4lc0n/MoCoBiBa/writedown.odt

Writedown MoCoBiBa

# Schaltplan

# Verbesserungsvorschläge:

# C direkt an Buck-Converter Vin

# Reverse Polarity Protection am Eingang (Schottky-Diode oder PMOS)

# V+ des Programmieradapter nicht routen, Buck Converter mag das nicht!

# Software

## Analog Input

Discarding first 10 inputs isn’t sufficient, changed to discard at least 30 samples

## LOW POWER

Thoughts:

- Sleep Mode with Watchdog Interrupt or MPU-Interrupt
- for normal operations: consider using 128kHz Watchdog Clock source
  - uses ~ 10 time less power
  - takes 10 times more to perform operations
- Checking for Light condition may be more current consuming than letting mpu run, because bike will be standing in the dark most of the day → Motion is a better Indicator for Riding
  - When Motion detected: Start sampling in low power mode

## Detecting Motion

- Sample MPU pretty slowly (32Hz should be sufficient for motion detection)
- either accel in z-direction (x, y may varry because if bike lays on one side)
  - acc-threshhold for pedaling, braking
- or calculate g-force, if g > 1.2 → Motion

# Löten

## Lötpaste auftragen

- Mit anderen Platinen einen ‘Cage’ aufbauen, in welchen die zu lötende Platine eingeklemmt wird.
- Mit Isolierband befestigt
- etwas Lötpaste am oberen Rand der Schablone auftragen
- mit z.B. einer Plastikkarte über die Schablone ziehen, auf guten Anpressdruck der Schablone achten, sonst verläuft die Paste
- bei kleinen Footprints (QFN o.Ä.) wenn Möglich etwas weniger auftragen, sonst Lötbrücken!

## Heißluft-Löten

- Umliegende Fläche aufheizen lassen
- ~~330°C,~~ Luftstrom Stufe 5, Temperatur: 270°C, verhindert dass Buck-Converter kaputt geht!
- kleinere Mittlere Düse für kleine Bauteile wie 0805 SMD
- bei Ics mit SOIC Füße einzeln erhitzen, diese sind groß genug, dass es sie fast nicht verzieht

Problem mit MPU-6500:

einige Lötbrücken entstanden

- wieder herauslöten mit Heißluft und Flussmittel
- mit Kupferlitze Lötzinn entfernen
- mit Zahnstocher geringste Mengen auftragen. Es ist wenig nötig, da bereits das Pad und die Füße bezinnt sind
- IC wieder auf Footprint setzen
- verlöten und beten, dass keine Lötbrücken entstehen!

Beim ersten Versuch ist eine Lötbrücke zw. VDDIO und AUX_CK, diese Stört aber (hoffentlich) nicht, da AUX_CK nicht verwendet wird (störte scheinbar doch)

Kurzschluss zwischen 3V3 und GND

- MPU-6500 verursachte Kurzschluss
- herunterlöten, Lötpads säubern, neu rauflöten hat das Problem gelöst

Lötpaste unter ATTINY84

- muss noch mal gereflowed werden!

Stromversorgung:

mit Kurzschluss/Lötbrücke am MPU-6500 hat der Spannungsregler keine Ausgangsspannung geliefert → Kurzschlussschutz?

Kurzschluss zw. SW und GND bzw 32Ω Widerstand

bei zweitem Buck-Converter: Kurzschluss zw. Vin und GND

–> Lösung: Temperatur von 330°C auf 270°C reduzieren, da IC nur max. 250°C aushält

ggf. Mit Lötkolben Pins nachlöten, wenn diese nicht heiß genug durch Luftstrom werden

# Programmieren

## Pin-Configuration

Alle Pins als Input, PULLUP

PIN | Direction | Value
DEBUG0 | 0 | 0
DEBUG1 | 0 | 0
LED | 0 | 0
ACC_INT | 0 | 0
V_BATT | 0 | 0
V_LIGHT | 0 | 0
V_SINK | INPUT | No pullup

## MPU-6500

Library für Attiny: usiTwiMaster von Donald R. Blake

Funktioniert auch mit 1MHz internal Clock

## ADC

Vorerst für 1MHz Clock konfiguriert

- ADC aktivieren
- Division Faktor auf 16 setzen → 62,5 kHz Clock (muss zw. 50K und 200kHz sein)
- ADCMUX [7:6] auf 0 → VCC als REF; [5:0] auf 1 → ADC1
- disable digital input buffer: DIDR0 auf a (PA1 und PA3 disable)
