4lc0n/MoCoBiBa/3d/v01.FCStd

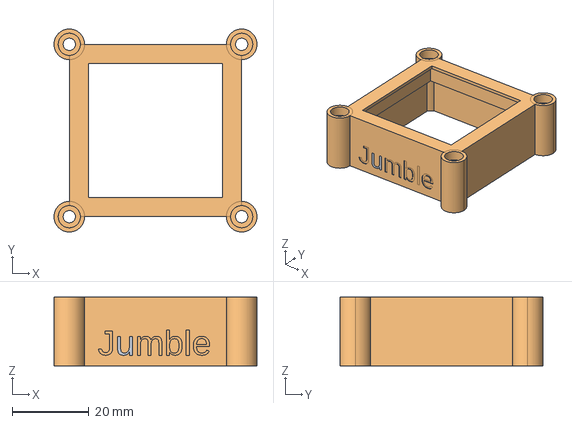
[picture p1: CAD file, 2020-11-13]
3d/v01.FCStd
53.0 x 53.0 x 18.0 mm
