4lc0n/MoCoBiBa/3d/v02_back_template.FCStd

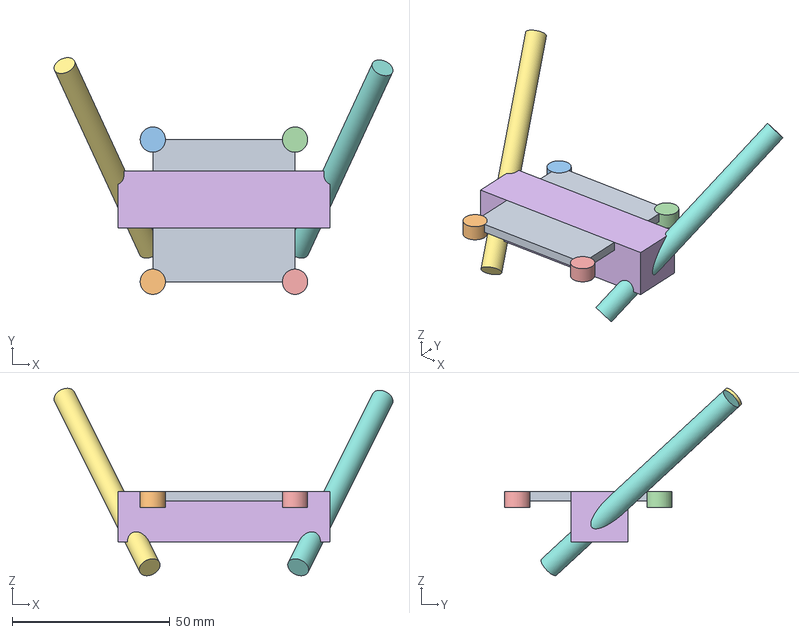
[picture p3: CAD file, 2020-11-13]
3d/v02_back_template.FCStd
107.3 x 74.9 x 59.4 mm
