4lc0n/MoCoBiBa/3d/v01_back_fem.FCStd

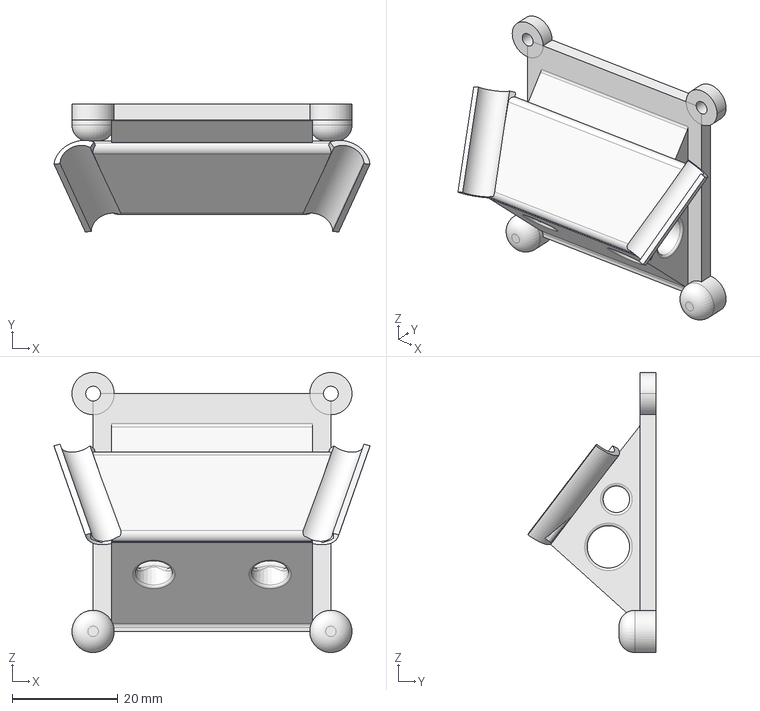
[picture p4: CAD file, 2020-11-13]
3d/v01_back_fem.FCStd
59.8 x 24.2 x 53.0 mm
