4lc0n/MoCoBiBa/3d/v01_rework_pre_zi.FCStd

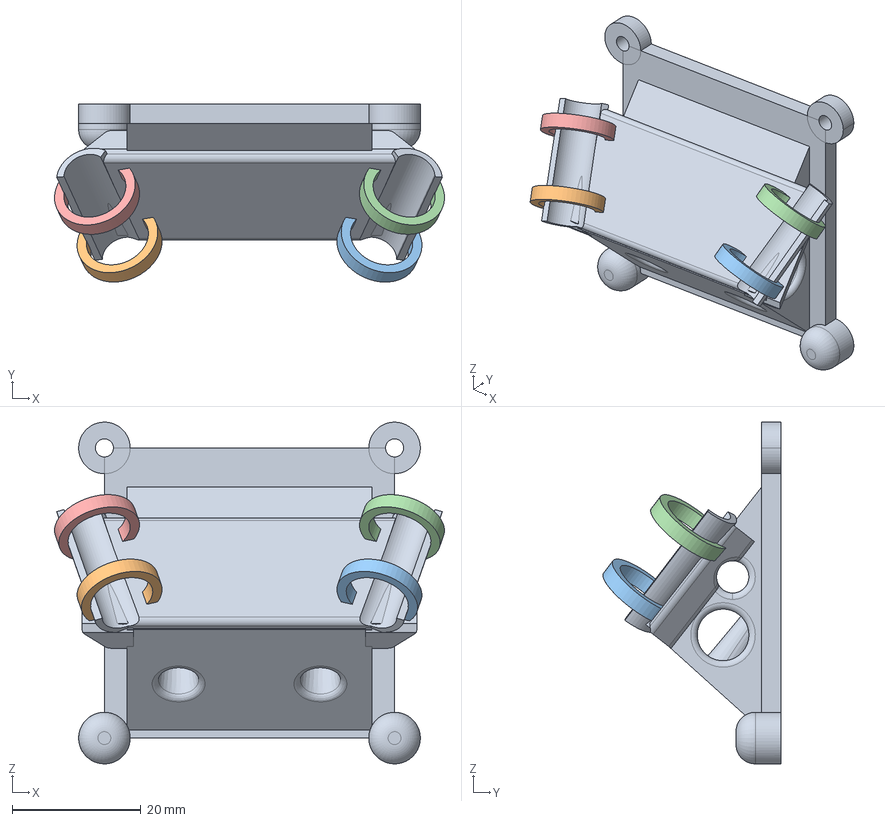
[picture p5: CAD file, 2020-11-13]
3d/v01_rework_pre_zi.FCStd
60.5 x 27.6 x 53.0 mm
lo
ru
ro
lu
