4lc0n/MoCoBiBa/3d/v02_2_back.FCStd

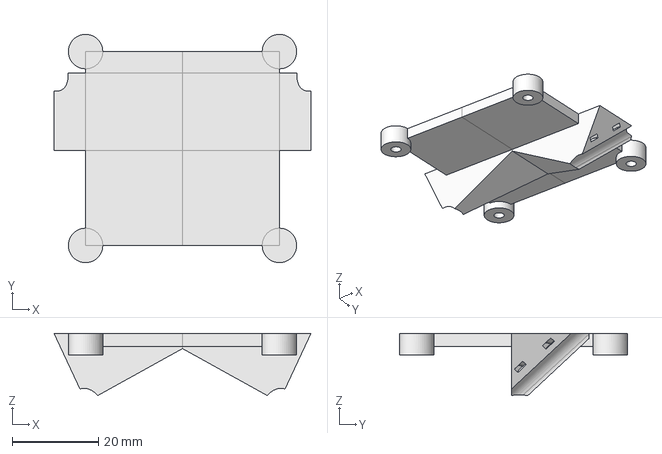
[picture p6: CAD file, 2020-11-13]
3d/v02_2_back.FCStd
59.7 x 53.0 x 14.5 mm
