4lc0n/MoCoBiBa/3d/v02_back.FCStd

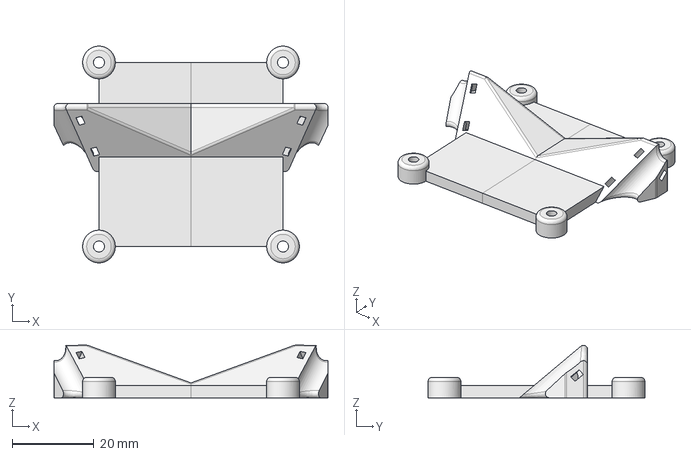
[picture p7: CAD file, 2020-11-13, an earlier design]
3d/v02_back.FCStd
67.0 x 53.0 x 12.8 mm
