4lc0n/MoCoBiBa/(list of files, cad)

Other CAD files:
3d/v01_rework.FCStd
3d/v01_back.FCStd
3d/v01.stl
3d/v01_back.stl
3d/v02_1_back.stl
3d/v02_2_back.stl
3d/v02_back.stl
