4lc0n/MoCoBiBa/MoCoBiBa/MoCoBiBa.kicad_pcb

## KiCad design MoCoBiBa/MoCoBiBa.kicad_pcb (2020-11-13, an earlier design)

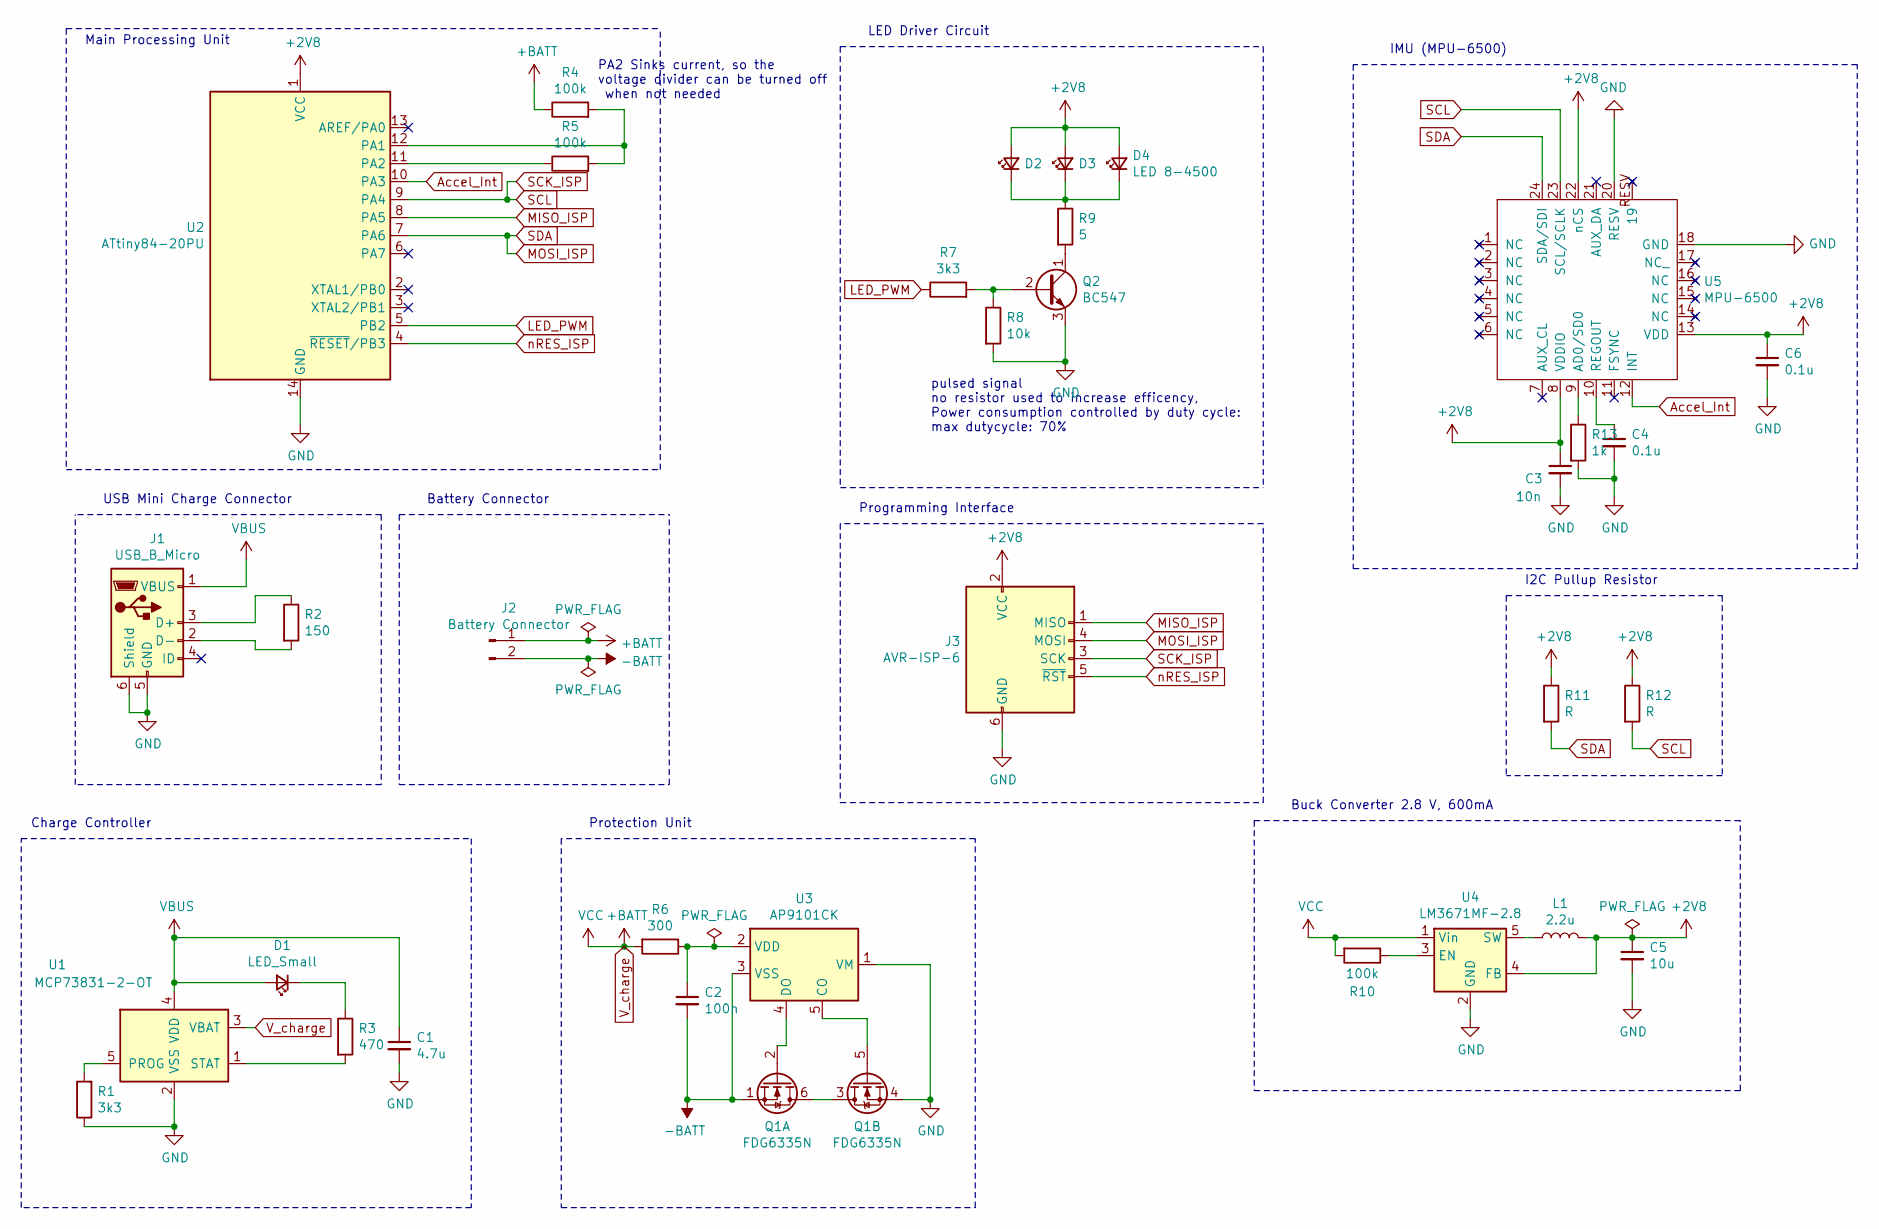
[picture p9: schematic MoCoBiBa.sch, MotionControlled Bicicle Backlight]

Parts:
C1: 4.7u; CP_Radial_D5.0mm_P2.00mm
C2: 100n; C_0805_2012Metric_Pad1.15x1.40mm_HandSolder
C3: 10n; C_Disc_D5.0mm_W2.5mm_P5.00mm
C4, C6: 0.1u; C_0805_2012Metric_Pad1.15x1.40mm_HandSolder
C5: 10u; CP_Radial_D5.0mm_P2.00mm
D1: LED_Small; LED_0805_2012Metric_Pad1.15x1.40mm_HandSolder
D2, D3, D4: LED 8-4500; LED_D8.0mm
J1: USB_B_Micro; USB_Mini-B_Wuerth_65100516121_Horizontal
J2: Battery Connector; PinSocket_1x02_P2.54mm_Vertical
J3: AVR-ISP-6; PinSocket_2x03_P2.54mm_Vertical
L1: 2.2u; L_0805_2012Metric_Pad1.15x1.40mm_HandSolder
Q1: FDG6335N; SOT-363_SC-70-6
Q2: BC547; TO-92_Inline
R1, R7: 3k3; R_0805_2012Metric_Pad1.15x1.40mm_HandSolder
R2: 150; R_0805_2012Metric_Pad1.15x1.40mm_HandSolder
R3: 470; R_0805_2012Metric_Pad1.15x1.40mm_HandSolder
R4, R5, R10: 100k; R_0805_2012Metric_Pad1.15x1.40mm_HandSolder
R6: 300; R_0805_2012Metric_Pad1.15x1.40mm_HandSolder
R8: 10k; R_0805_2012Metric_Pad1.15x1.40mm_HandSolder
R9: 5; R_0815_2038Metric_Pad1.53x4.00mm_HandSolder
R11, R12: R; R_0815_2038Metric_Pad1.53x4.00mm_HandSolder
R13: 1k; R_0805_2012Metric_Pad1.15x1.40mm_HandSolder
U1: MCP73831-2-OT; SOT-23-5
U2: ATtiny84-20PU; DIP-14_W7.62mm
U3: AP9101CK; SOT-23-5
U4: LM3671MF-2.8; TSOT-23-5
U5: MPU-6500; InvenSense_QFN-24_3x3mm_P0.4mm

Connections:
+2V8: C3.1, C5.1, C6.1, D2.2 (A), D3.2 (A), D4.2 (A), J3.2 (VCC), L1.2, R11.1, R12.1, U2.1 (VCC), U4.4 (FB), U5.8 (VDDIO), U5.13 (VDD), U5.22 (nCS)
-BATT: C2.2, J2.2, Q1.1 (S), U3.3 (VSS)
Accel_Int: U2.10 (PA3), U5.12 (INT)
GND: C1.2, C3.2, C4.2, C5.2, C6.2, J1.5 (GND), J1.6 (Shield), J3.6 (GND), Q1.4 (S), Q2.3 (E), R1.1, R8.2, R13.2, U1.2 (VSS), U2.14 (GND), U3.1 (VM), U4.2 (GND), U5.18 (GND), U5.20 (RESV)
LED_PWM: R7.1, U2.5 (PB2)
MISO_ISP: J3.1 (MISO), U2.8 (PA5)
MOSI_ISP: J3.4 (MOSI), R11.2, U2.7 (PA6), U5.24 (SDA/SDI)
unnamed: C2.1, R6.1, U3.2 (VDD)
unnamed: C4.1, U5.10 (REGOUT)
unnamed: D1.1 (K), R3.1
unnamed: D2.1 (K), D3.1 (K), D4.1 (K), R9.1
unnamed: J1.2 (D-), R2.2
unnamed: J1.3 (D+), R2.1
unnamed: L1.1, U4.5 (SW)
unnamed: Q1.2 (G), U3.4 (DO)
unnamed: Q1.3 (D), Q1.6 (D)
unnamed: Q1.5 (G), U3.5 (CO)
unnamed: Q2.1 (C), R9.2
unnamed: Q2.2 (B), R7.2, R8.1
unnamed: R1.2, U1.5 (PROG)
unnamed: R3.2, U1.1 (STAT)
unnamed: R4.2, R5.2, U2.12 (PA1)
unnamed: R5.1, U2.11 (PA2)
unnamed: R10.1, U4.3 (EN)
unnamed: R13.1, U5.9 (AD0/SD0)
SCK_ISP: J3.3 (SCK), R12.2, U2.9 (PA4), U5.23 (SCL/SCLK)
VBUS: C1.1, D1.2 (A), J1.1 (VBUS), U1.4 (VDD)
V_charge: J2.1, R4.1, R6.2, R10.2, U1.3 (VBAT), U4.1 (Vin)
nRES_ISP: J3.5 (~RST), U2.4 (~RESET~/PB3)

Notes on the sheet:
Charge Controller
Protection Unit
pulsed signal no resistor used to increase efficency, Power consumption controlled by duty cycle: max dutycycle: 70%
Buck Converter 2.8 V, 600mA
USB Mini Charge Connector
Battery Connector
Main Processing Unit
LED Driver Circuit
IMU (MPU-6500)
Programming Interface
I2C Pullup Resistor
PA2 Sinks current, so the voltage divider can be turned off when not needed

Board: 2 copper layers, 34 parts (0 on the bottom side), 29 nets, no tracks yet.
