4lc0n/MoCoBiBa/MoCoBiBa_tiny/MoCoBiBa_no_charger.kicad_pcb

## KiCad design MoCoBiBa_tiny/MoCoBiBa_no_charger.kicad_pcb (2020-11-13)

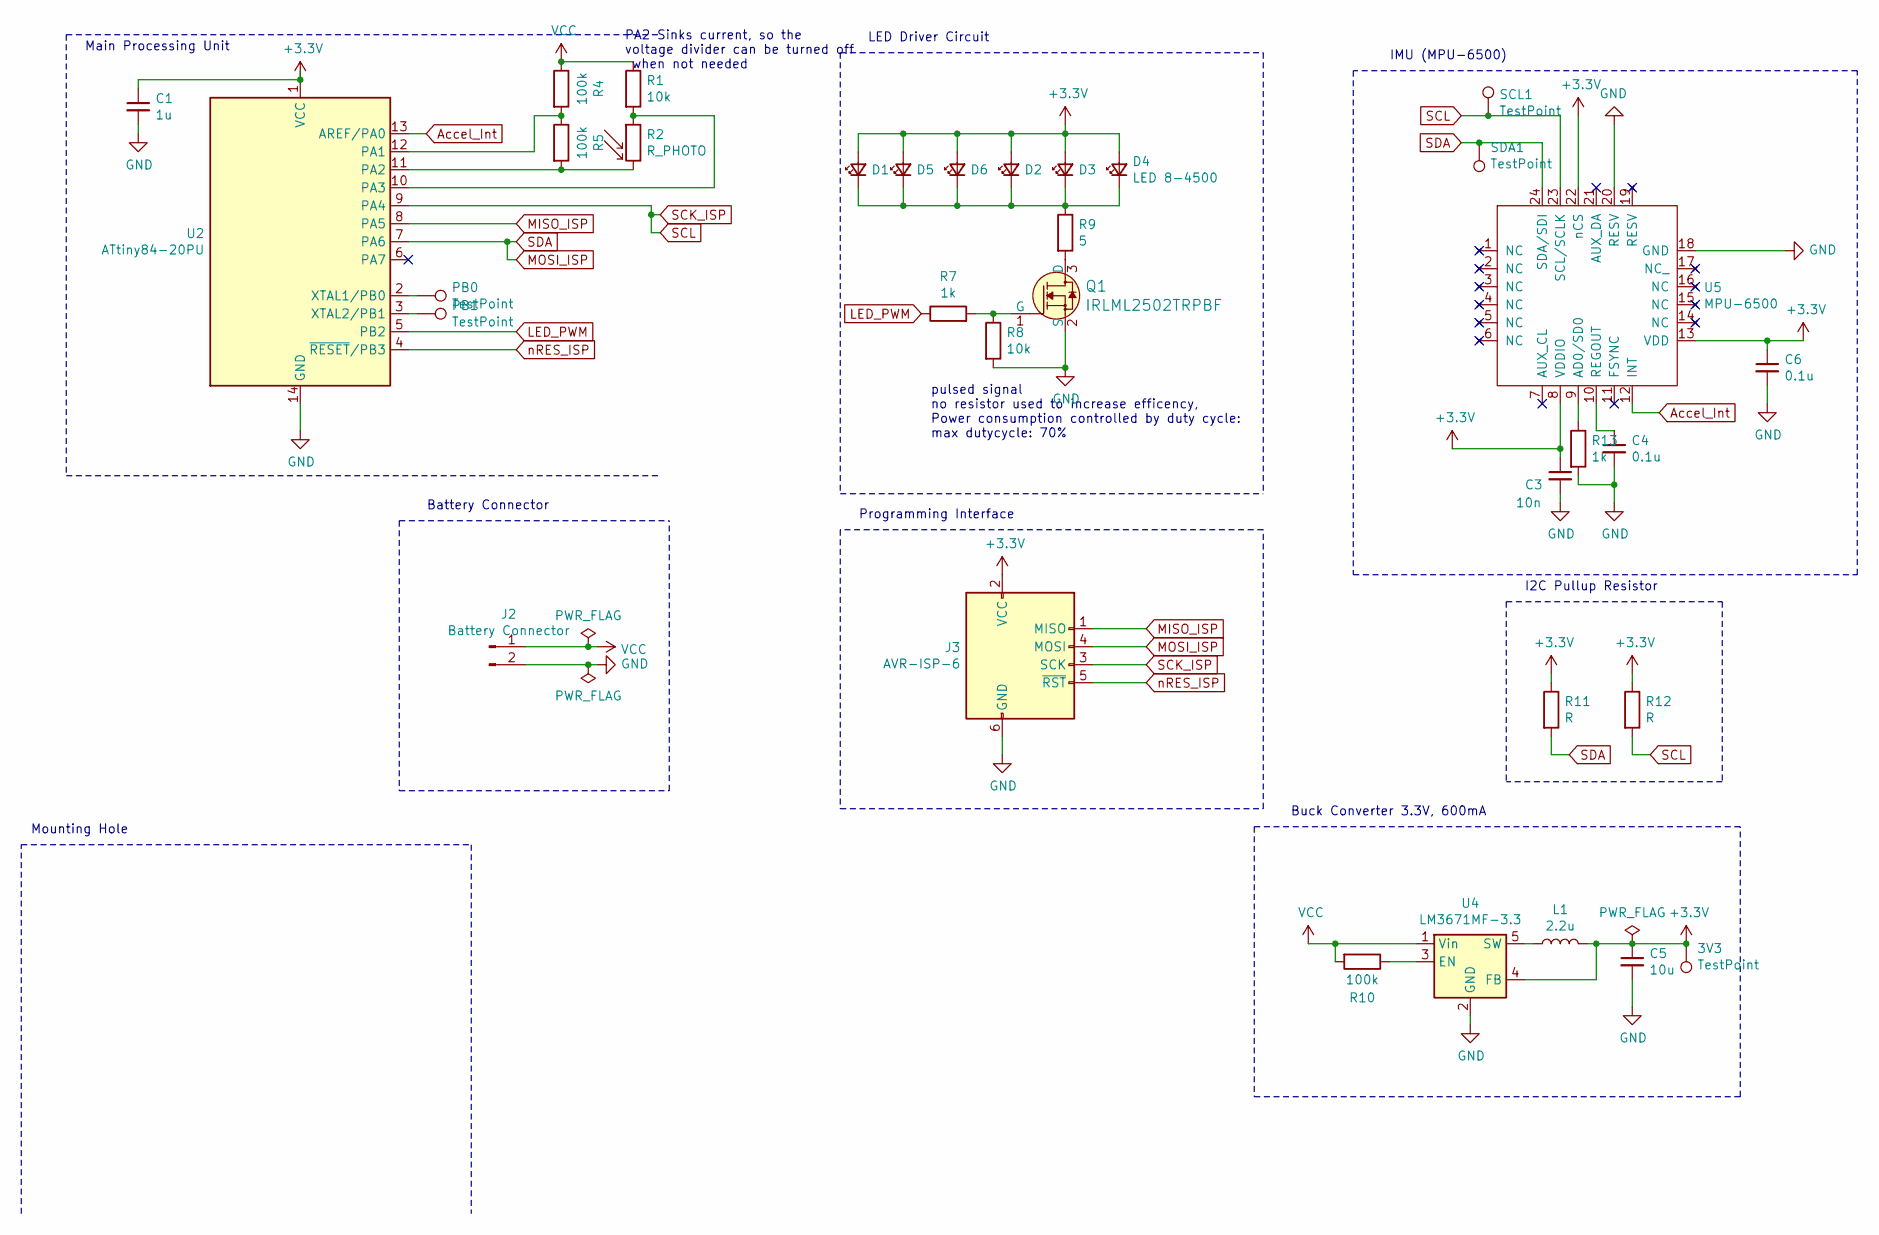
[picture p10: schematic MoCoBiBa_no_charger.sch, MotionControlled Bicicle Backlight]

Parts:
3V3: TestPoint; TestPoint_Pad_D1.5mm
C1: 1u; C_0805_2012Metric_Pad1.15x1.40mm_HandSolder
C3: 10n; C_0805_2012Metric_Pad1.15x1.40mm_HandSolder
C4, C6: 0.1u; C_0805_2012Metric_Pad1.15x1.40mm_HandSolder
C5: 10u; C_0805_2012Metric_Pad1.15x1.40mm_HandSolder
D1, D2, D3, D4, D5, D6: LED 8-4500; LED_PLCC-2
J2: Battery Connector; PinSocket_1x02_P2.54mm_Vertical
J3: AVR-ISP-6; PinSocket_2x03_P2.54mm_Vertical
L1: 2.2u; L_0805_2012Metric_Pad1.15x1.40mm_HandSolder
PB0, PB1: TestPoint; TestPoint_Pad_D1.5mm
Q1: IRLML2502TRPBF; SOT-23-3; MPN IRLML2502TRPBF; Digi-Key_PN IRLML2502TRPBFCT-ND
R1, R8: 10k; R_0805_2012Metric_Pad1.15x1.40mm_HandSolder
R2: R_PHOTO; R_Axial_DIN0204_L3.6mm_D1.6mm_P2.54mm_Vertical
R4, R5, R10: 100k; R_0805_2012Metric_Pad1.15x1.40mm_HandSolder
R7, R13: 1k; R_0805_2012Metric_Pad1.15x1.40mm_HandSolder
R9: 5; R_0815_2038Metric_Pad1.53x4.00mm_HandSolder
R11, R12: R; R_0805_2012Metric_Pad1.15x1.40mm_HandSolder
SCL1: TestPoint; TestPoint_Pad_D1.5mm
SDA1: TestPoint; TestPoint_Pad_D1.5mm
U2: ATtiny84-20PU; SOIC-14_3.9x8.7mm_P1.27mm
U4: LM3671MF-3.3; TSOT-23-5
U5: MPU-6500; InvenSense_QFN-24_3x3mm_P0.4mm

Connections:
+3V3: 3V3.1, C1.1, C3.1, C5.1, C6.1, D1.2 (A), D2.2 (A), D3.2 (A), D4.2 (A), D5.2 (A), D6.2 (A), J3.2 (VCC), L1.2, R11.1, R12.1, U2.1 (VCC), U4.4 (FB), U5.8 (VDDIO), U5.13 (VDD), U5.22 (nCS)
Accel_Int: U2.13 (AREF/PA0), U5.12 (INT)
GND: C1.2, C3.2, C4.2, C5.2, C6.2, J2.2, J3.6 (GND), Q1.2 (S), R8.2, R13.2, U2.14 (GND), U4.2 (GND), U5.18 (GND), U5.20 (RESV)
LED_PWM: R7.1, U2.5 (PB2)
MISO_ISP: J3.1 (MISO), U2.8 (PA5)
MOSI_ISP: J3.4 (MOSI), R11.2, SDA1.1, U2.7 (PA6), U5.24 (SDA/SDI)
unnamed: C4.1, U5.10 (REGOUT)
unnamed: D1.1 (K), D2.1 (K), D3.1 (K), D4.1 (K), D5.1 (K), D6.1 (K), R9.1
unnamed: L1.1, U4.5 (SW)
unnamed: PB0.1, U2.2 (XTAL1/PB0)
unnamed: PB1.1, U2.3 (XTAL2/PB1)
unnamed: Q1.1 (G), R7.2, R8.1
unnamed: Q1.3 (D), R9.2
unnamed: R1.2, R2.1, U2.10 (PA3)
unnamed: R2.2, R5.2, U2.11 (PA2)
unnamed: R4.2, R5.1, U2.12 (PA1)
unnamed: R10.1, U4.3 (EN)
unnamed: R13.1, U5.9 (AD0/SD0)
SCK_ISP: J3.3 (SCK), R12.2, SCL1.1, U2.9 (PA4), U5.23 (SCL/SCLK)
VCC: J2.1, R1.1, R4.1, R10.2, U4.1 (Vin)
nRES_ISP: J3.5 (~RST), U2.4 (~RESET~/PB3)

Notes on the sheet:
Mounting Hole
pulsed signal no resistor used to increase efficency, Power consumption controlled by duty cycle: max dutycycle: 70%
Buck Converter 3.3V, 600mA
Battery Connector
Main Processing Unit
LED Driver Circuit
IMU (MPU-6500)
Programming Interface
I2C Pullup Resistor
PA2 Sinks current, so the voltage divider can be turned off when not needed

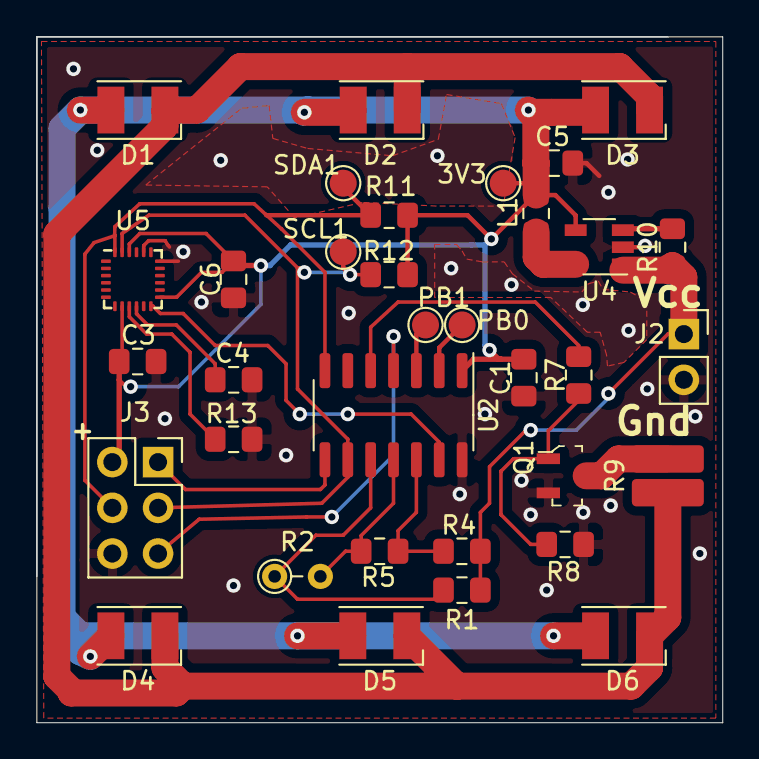
[picture p11: board MoCoBiBa_no_charger.kicad_pcb from above]

Board: 2 copper layers, 38.1 x 38.1 mm, 34 parts (0 on the bottom side), 21 nets.
