4lc0n/MoCoBiBa/(commit log)

2020-11-30 added power_consumption calculation, brightness readout * power_consumptoin.ods spreadsheet with consumption calculation from MPU-6500 and AtTiny84 Datasheet * writedown with programm thoughts * writ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
    [power_consumption.ods]
2020-12-01 minor changes to programm flow
2020-12-02 added PCINT and State Machine * Pin Change Interrupt with setup and deactivate implemented * fixed bug on no TWI after sleep
    [main.c, main.h]
2021-01-04 added FIR Filter Files from t-filter.engineerjs.com and separated MPU functions
