4lc0n/MoCoBiBa/(notices)

Notices in the files:
usiTwiMaster/usiTwiMaster.c:
This program is free software; you can redistribute it and/or modify it under the
terms of the GNU General Public License as published by the Free Software
